josekun13/Ein/README.md

# Ein

## Description

Ein :dog: is a printable robot easy to replicate and modify designed with educational and research purpose in mind.

If this material is useful to you please reference it :smiley: .
