josekun13/Ein/3D models/bottomEin.stl

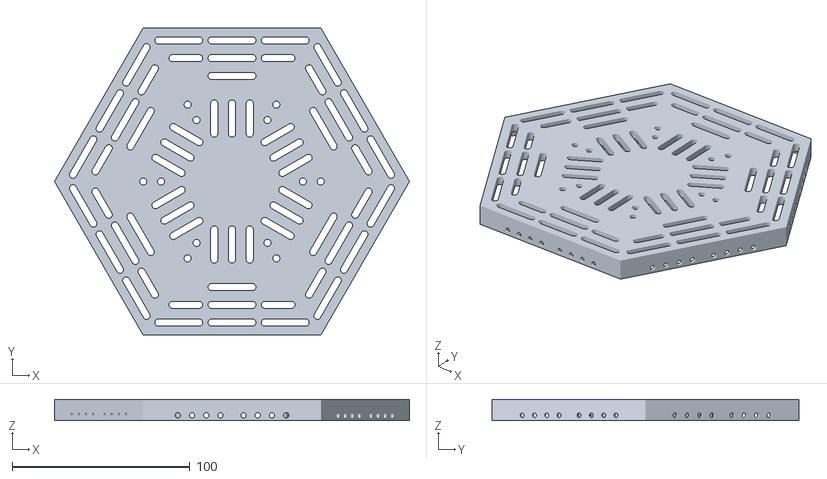
[picture p1: CAD file, 2022-06-10]
3D models/bottomEin.stl
200.0 x 173.2 x 12.0
