josekun13/Ein/3D models/TopEin.stl

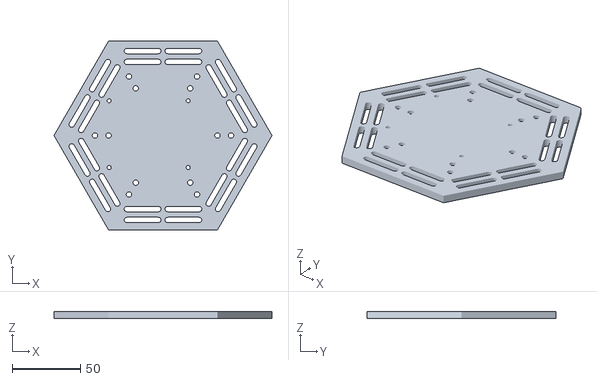
[picture p2: CAD file, 2022-06-10]
3D models/TopEin.stl
160.0 x 138.6 x 5.00
