josekun13/Ein/3D models/CameraSupport.stl

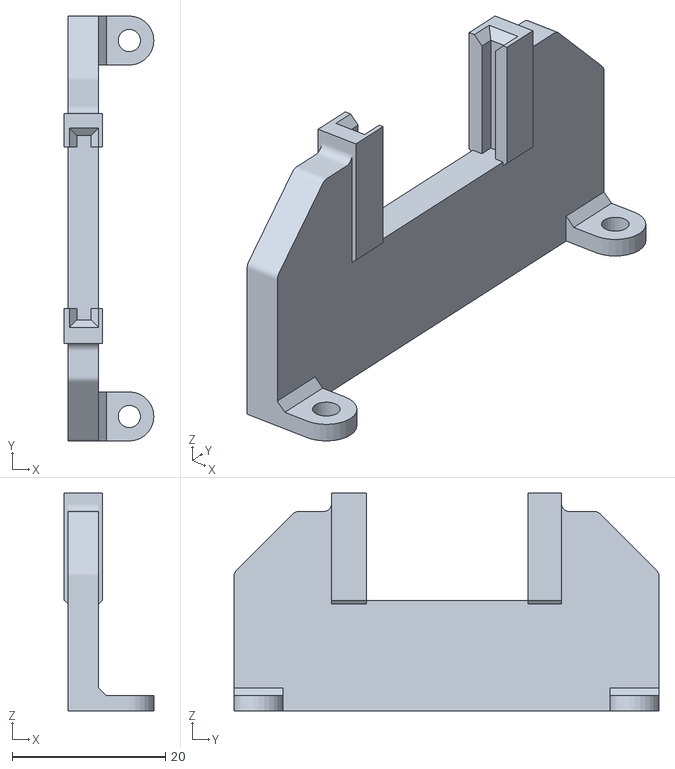
[picture p3: CAD file, 2022-06-10]
3D models/CameraSupport.stl
11.7 x 55.4 x 28.4
