josekun13/Ein/3D models/printable_ein.fcstd

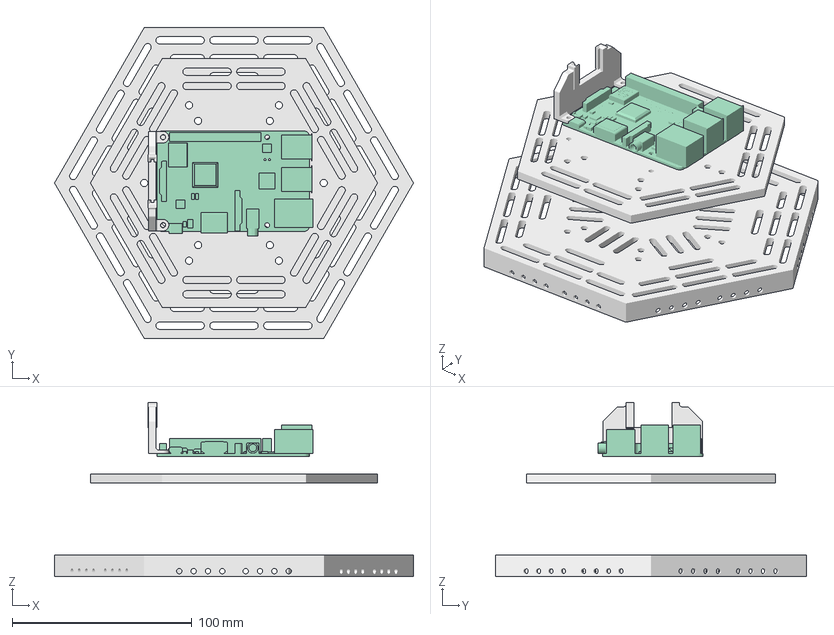
[picture p4: CAD file, 2020-03-17]
3D models/printable_ein.fcstd
200.0 x 173.2 x 97.0 mm
raspy3b
